didjcodt/WafDMX/README.md

# WafDMX
Ultra-simple DMX controller for LED strips
