didjcodt/WafDMX/hardware/PCB/WafDMX.kicad_pcb

## KiCad design hardware/PCB/WafDMX.kicad_pcb (2019-06-09)

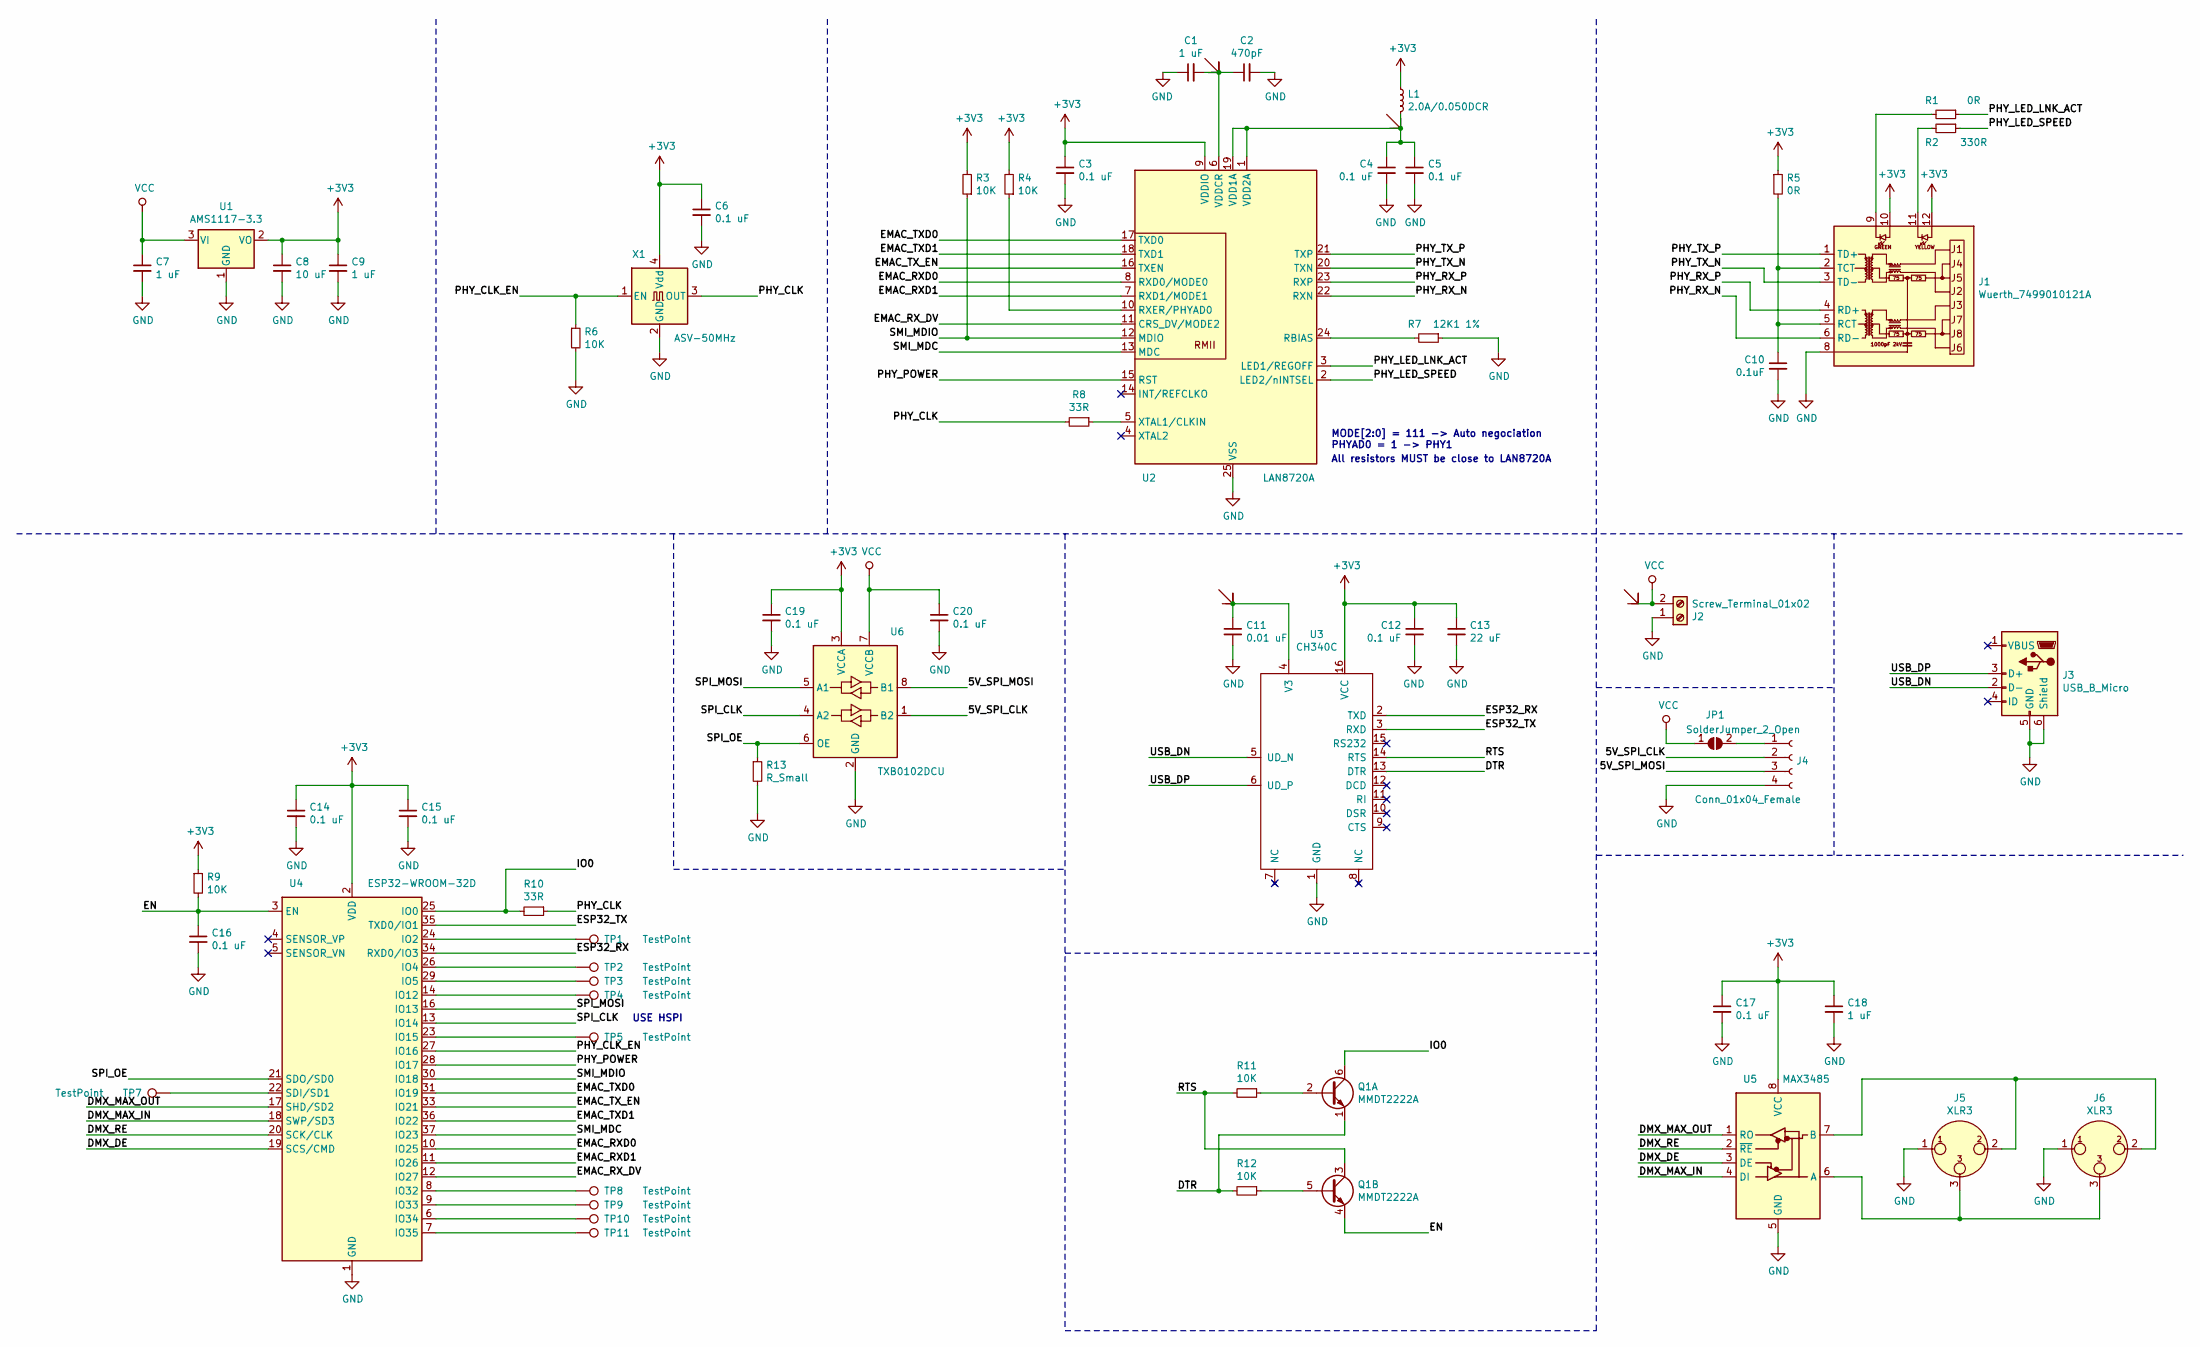
[picture p1: schematic WafDMX.sch, WafDMX - DMX controller]

Parts:
C1, C7, C9, C18: 1 uF; C_0603_1608Metric
C2: 470pF; C_0603_1608Metric
C3, C4, C5, C6, C12, C14, C15, C16, C17, C19, C20: 0.1 uF; C_0603_1608Metric
C8: 10 uF; C_1206_3216Metric
C10: 0.1uF; C_0603_1608Metric
C11: 0.01 uF; C_0603_1608Metric
C13: 22 uF; C_1206_3216Metric
J1: Wuerth_7499010121A; RJ45_Wuerth_7499010121A_Horizontal
J2: Screw_Terminal_01x02; TerminalBlock_WAGO_2604-1102_2x05_P5.00mm_30Degree
J3: USB_B_Micro; USB_Micro-B_Molex-105017-0001
J4: Conn_01x04_Female; PinHeader_1x04_P2.54mm_Vertical
J5: XLR3; XLR_Neutrik_NC3FAAH_Horizontal
J6: XLR3; XLR_Neutrik_NC3MAAH_Horizontal
JP1: SolderJumper_2_Open; SolderJumper-2_P1.3mm_Open_Pad1.0x1.5mm
L1: 2.0A/0.050DCR; L_0603_1608Metric
P1, P2, P3, P4: POW_OUT
Q1: MMDT2222A; SOT-363_SC-70-6
R1, R5: 0R; R_0603_1608Metric
R2: 330R; R_0603_1608Metric
R3, R4, R6, R9, R11, R12: 10K; R_0603_1608Metric
R7: 12K1 1%; R_0603_1608Metric
R8, R10: 33R; R_0603_1608Metric
R13: R_Small; R_0603_1608Metric
TP1, TP2, TP3, TP4, TP5, TP7, TP8, TP9, TP10, TP11: TestPoint; TestPoint_THTPad_1.0x1.0mm_Drill0.5mm
U1: AMS1117-3.3; SOT-223-3_TabPin2
U2: LAN8720A; QFN-24-1EP_4x4mm_P0.5mm_EP2.6x2.6mm
U3: CH340C; SOP-16_4.4x10.4mm_P1.27mm
U4: ESP32-WROOM-32D; ESP32-WROOM-32
U5: MAX3485; SOIC-8_3.9x4.9mm_P1.27mm
U6: TXB0102DCU; VSSOP-8_2.4x2.1mm_P0.5mm
X1: ASV-50MHz; Oscillator_SMD_Abracon_ASV-4Pin_7.0x5.1mm

Connections:
+3V3: C3.1, C6.1, C8.1, C9.1, C12.1, C13.1, C14.1, C15.1, C17.1, C18.1, C19.1, J1.10, J1.12, L1.1, R3.2, R4.2, R5.1, R9.1, U1.2 (VO), U2.9 (VDDIO), U3.16 (VCC), U4.2 (VDD), U5.8 (VCC), U6.3 (VCCA), X1.4 (Vdd)
/5V_SPI_CLK: J4.2, U6.1 (B2)
/5V_SPI_MOSI: J4.3, U6.8 (B1)
/DMX_DE: U4.19 (SCS/CMD), U5.3 (DE)
/DMX_MAX_IN: U4.18 (SWP/SD3), U5.4 (DI)
/DMX_MAX_OUT: U4.17 (SHD/SD2), U5.1 (RO)
/DMX_RE: U4.20 (SCK/CLK), U5.2 (~RE)
/DTR: Q1.1 (E1), R12.2, U3.13 (DTR)
/EMAC_RXD0: U2.8 (RXD0/MODE0), U4.10 (IO25)
/EMAC_RXD1: U2.7 (RXD1/MODE1), U4.11 (IO26)
/EMAC_RX_DV: U2.11 (CRS_DV/MODE2), U4.12 (IO27)
/EMAC_TXD0: U2.17 (TXD0), U4.31 (IO19)
/EMAC_TXD1: U2.18 (TXD1), U4.36 (IO22)
/EMAC_TX_EN: U2.16 (TXEN), U4.33 (IO21)
/EN: C16.1, Q1.4 (E2), R9.2, U4.3 (EN)
/ESP32_RX: U3.2 (TXD), U4.34 (RXD0/IO3)
/ESP32_TX: U3.3 (RXD), U4.35 (TXD0/IO1)
/IO0: Q1.6 (C1), R10.2, U4.25 (IO0)
/PHY_CLK: R8.2, R10.1, X1.3 (OUT)
/PHY_CLK_EN: R6.1, U4.27 (IO16), X1.1 (EN)
/PHY_LED_LNK_ACT: R1.1, U2.3 (LED1/REGOFF)
/PHY_LED_SPEED: R2.1, U2.2 (LED2/nINTSEL)
/PHY_POWER: U2.15 (RST), U4.28 (IO17)
/PHY_RX_N: J1.6 (RD-), U2.22 (RXN)
/PHY_RX_P: J1.4 (RD+), U2.23 (RXP)
/PHY_TX_N: J1.3 (TD-), U2.20 (TXN)
/PHY_TX_P: J1.1 (TD+), U2.21 (TXP)
/RTS: Q1.3 (C2), R11.2, U3.14 (RTS)
/SMI_MDC: U2.13 (MDC), U4.37 (IO23)
/SMI_MDIO: R3.1, U2.12 (MDIO), U4.30 (IO18)
/SPI_CLK: U4.13 (IO14), U6.4 (A2)
/SPI_MOSI: U4.16 (IO13), U6.5 (A1)
/SPI_OE: R13.1, U4.21 (SDO/SD0), U6.6 (OE)
/USB_DN: J3.2 (D-), U3.5 (UD_N)
/USB_DP: J3.3 (D+), U3.6 (UD_P)
GND: C1.1, C2.2, C3.2, C4.2, C5.2, C6.2, C7.2, C8.2, C9.2, C10.2, C11.2, C12.2, C13.2, C14.2, C15.2, C16.2, C17.2, C18.2, C19.2, C20.2, J1.8, J2.1, J3.5 (GND), J3.6 (Shield), J4.4, J5.1, J6.1, R6.2, R7.1, R13.2, U1.1 (GND), U2.25 (VSS), U3.1 (GND), U4.1 (GND), U4.15 (GND), U4.38 (GND), U5.5 (GND), U6.2 (GND), X1.2 (GND)
unnamed: C1.2, C2.1, P2.~, U2.6 (VDDCR)
unnamed: C4.1, C5.1, L1.2, P4.~, U2.1 (VDD2A), U2.19 (VDD1A)
unnamed: C10.1, J1.2 (TCT), J1.5 (RCT), R5.2
unnamed: C11.1, P3.~, U3.4 (V3)
unnamed: J1.9, R1.2
unnamed: J1.11, R2.2
unnamed: J4.1, JP1.2 (B)
unnamed: J5.2, J6.2, U5.7 (B)
unnamed: J5.3, J6.3, U5.6 (A)
unnamed: Q1.2 (B1), R11.1
unnamed: Q1.5 (B2), R12.1
unnamed: R4.1, U2.10 (RXER/PHYAD0)
unnamed: R7.2, U2.24 (RBIAS)
unnamed: R8.1, U2.5 (XTAL1/CLKIN)
unnamed: TP1.1, U4.24 (IO2)
unnamed: TP2.1, U4.26 (IO4)
unnamed: TP3.1, U4.29 (IO5)
unnamed: TP4.1, U4.14 (IO12)
unnamed: TP5.1, U4.23 (IO15)
unnamed: TP7.1, U4.22 (SDI/SD1)
unnamed: TP8.1, U4.8 (IO32)
unnamed: TP9.1, U4.9 (IO33)
unnamed: TP10.1, U4.6 (IO34)
unnamed: TP11.1, U4.7 (IO35)
VCC: C7.1, C20.1, J2.2, JP1.1 (A), P1.~, U1.3 (VI), U6.7 (VCCB)

Notes on the sheet:
USE HSPI
All resistors MUST be close to LAN8720A
MODE[2:0] = 111 -> Auto negociation PHYAD0 = 1 -> PHY1

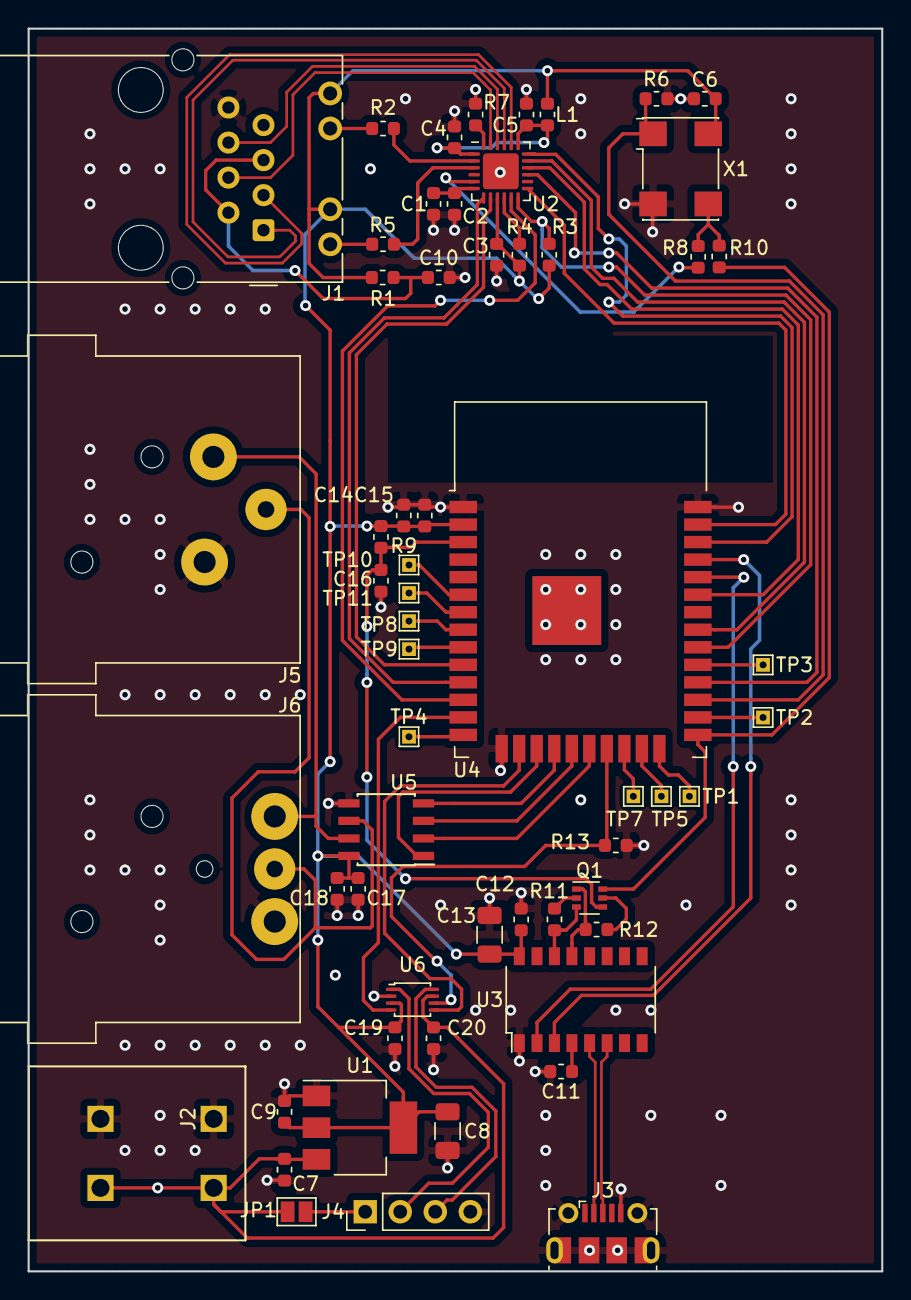
[picture p2: board WafDMX.kicad_pcb from above]

Board: 2 copper layers, 61.8 x 90.0 mm, 59 parts (0 on the bottom side), 61 nets.
