didjcodt/WafDMX/software/main/eth.c

#include "eth.h"

#include <stdio.h>
#include <string.h>

// FreeRTOS includes
#include "driver/gpio.h"
#include "freertos/FreeRTOS.h"
#include "freertos/task.h"

// ESP specific includes
#include "esp_eth.h"
#include "esp_event.h"
#include "esp_log.h"

// Other
#include "tcpip_adapter.h"
#include "wifi.h"

static const char *TAG = "ETH";
static esp_eth_handle_t s_eth_handle = NULL;

static void eth_event_handler(void *arg, esp_event_base_t event_base,
                              int32_t event_id, void *event_data) {
    switch (event_id) {
        case ETHERNET_EVENT_CONNECTED:
            ESP_LOGI(TAG, "Ethernet Link Up");
            break;
        case ETHERNET_EVENT_DISCONNECTED:
            ESP_LOGI(TAG, "Ethernet Link Down");
            break;
        case ETHERNET_EVENT_START:
            ESP_LOGI(TAG, "Ethernet Started");
            break;
        case ETHERNET_EVENT_STOP:
            ESP_LOGI(TAG, "Ethernet Stopped");
            break;
        default:
            break;
    }
}

static void got_ip_event_handler(void *arg, esp_event_base_t event_base,
                                 int32_t event_id, void *event_data) {
    ip_event_got_ip_t *event = (ip_event_got_ip_t *)event_data;
    const tcpip_adapter_ip_info_t *ip_info = &event->ip_info;

    ESP_LOGI(TAG, "Ethernet Got IP Address");
    ESP_LOGI(TAG, "ETHIP:" IPSTR, IP2STR(&ip_info->ip));
    ESP_LOGI(TAG, "ETHMASK:" IPSTR, IP2STR(&ip_info->netmask));
    ESP_LOGI(TAG, "ETHGW:" IPSTR, IP2STR(&ip_info->gw));

    xEventGroupSetBits(net_event_group, ETH_CONNECTED_BIT);
}

void eth_init() {
    // Enable PHY
    // Clock EN on GPIO16
    // PHY EN on GPIO17
    gpio_pad_select_gpio(16);
    gpio_set_direction(16, GPIO_MODE_OUTPUT);
    gpio_set_level(16, 1);

    ESP_ERROR_CHECK(esp_event_handler_register(ETH_EVENT, ESP_EVENT_ANY_ID,
                                               &eth_event_handler, NULL));
    ESP_ERROR_CHECK(esp_event_handler_register(IP_EVENT, IP_EVENT_ETH_GOT_IP,
                                               &got_ip_event_handler, NULL));

    eth_mac_config_t mac_config = ETH_MAC_DEFAULT_CONFIG();
    esp_eth_mac_t *mac = esp_eth_mac_new_esp32(&mac_config);
    eth_phy_config_t phy_config = ETH_PHY_DEFAULT_CONFIG();
    esp_eth_phy_t *phy = esp_eth_phy_new_lan8720(&phy_config);
    esp_eth_config_t config = ETH_DEFAULT_CONFIG(mac, phy);
    ESP_ERROR_CHECK(esp_eth_driver_install(&config, &s_eth_handle));
}
