didjcodt/WafDMX/(commit log)

2019-06-03 Add ESP32, LDO, MAX3485 and LAN8720A
    [WafDMX.kicad_pcb, WafDMX.sch]
2019-06-04 Add LAN8720A and trace
    [WafDMX.sch]
2019-06-04 Use A3 paper size, add CH340C
    [WafDMX.sch]
2019-06-05 Place components
    [WafDMX.kicad_pcb, WafDMX.sch]
2019-06-06 Change Testpoints to TH, start placing
    [WafDMX.kicad_pcb, WafDMX.sch]
2019-06-06 First routing of PCB
    [WafDMX.kicad_pcb]
2019-06-08 Add XLR Connector
2019-06-09 Add routing
    [WafDMX.kicad_pcb, WafDMX.sch]
2019-06-09 Add 3V3-5V level shifter
    [WafDMX.kicad_pcb, WafDMX.sch]
2019-06-09 Add 3dshape for rj45
    [WafDMX.kicad_pcb]
2019-06-11 Add farnell references
    [WafDMX.sch]
2019-07-23 Fix CH340C D-/D+ inversion
    [WafDMX.sch]
2019-07-23 Mode SPI_OE on GPIO13
    [WafDMX.sch]
2019-07-23 Uniformise component values
    [WafDMX.sch]
2019-08-26 Add FPGA and LCD screen, bump to v2
    [WafDMX.sch]
